leonhiem/codeswitch/README.md

# codeswitch
Codeswitch to open/close a relay
