leonhiem/codeswitch/pcb/pcb.pdf

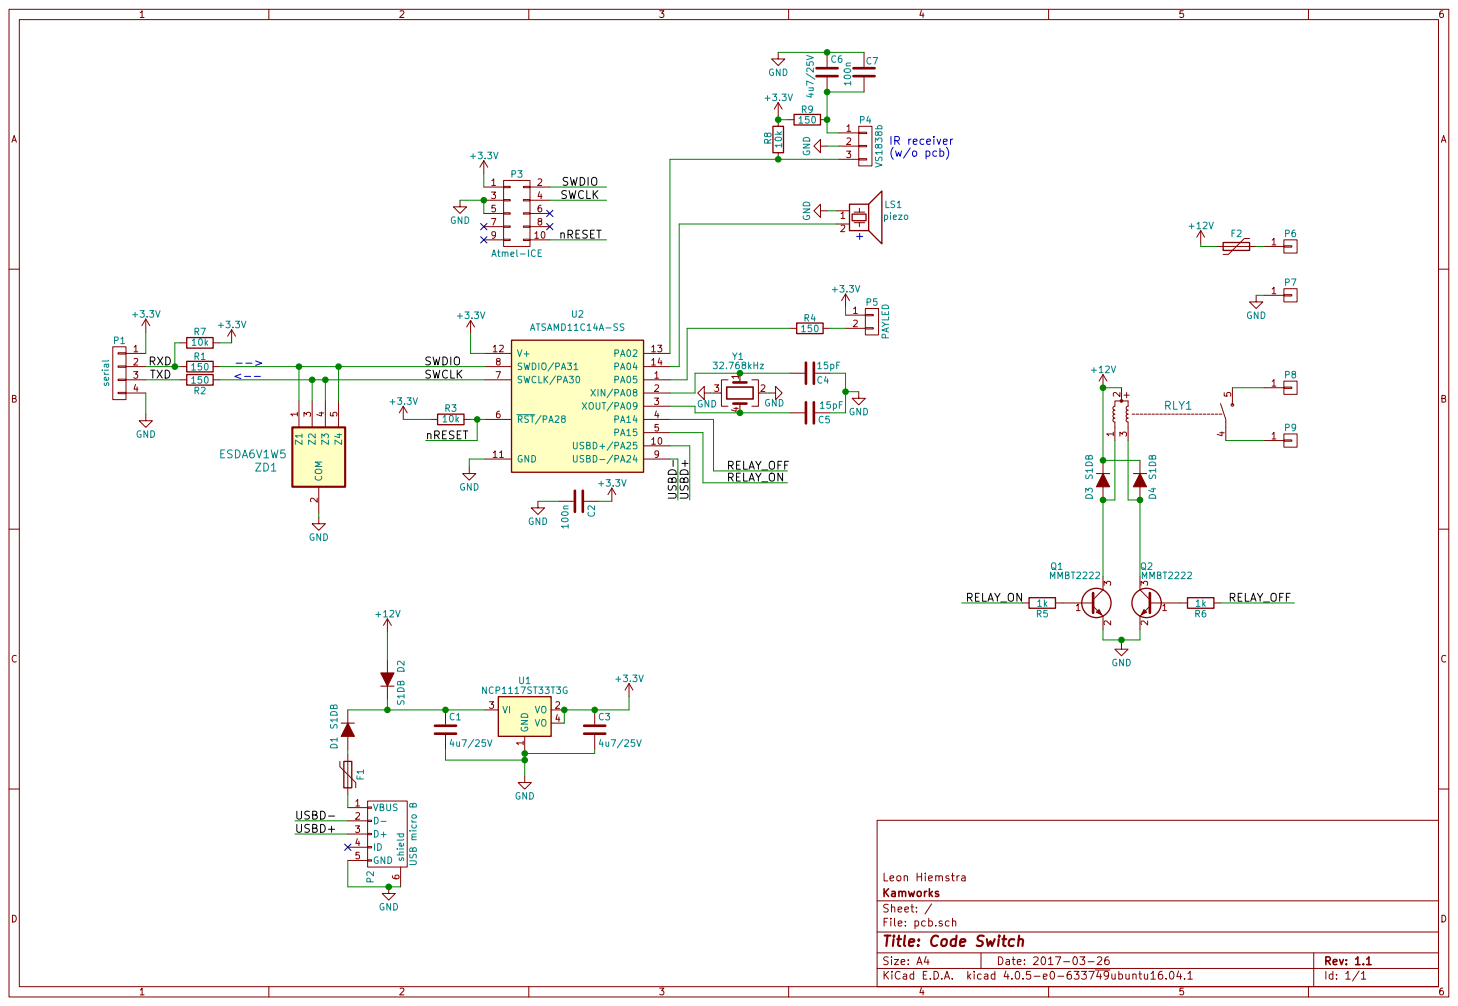
[picture p2: page 1]

Leon Hiemstra
File: pcb.sch Sheet: / Kamworks

Id: 1/1 Title: Code Switch
