leonhiem/codeswitch/pcb/pcb.kicad_pcb

## KiCad design pcb/pcb.kicad_pcb (2021-10-01)

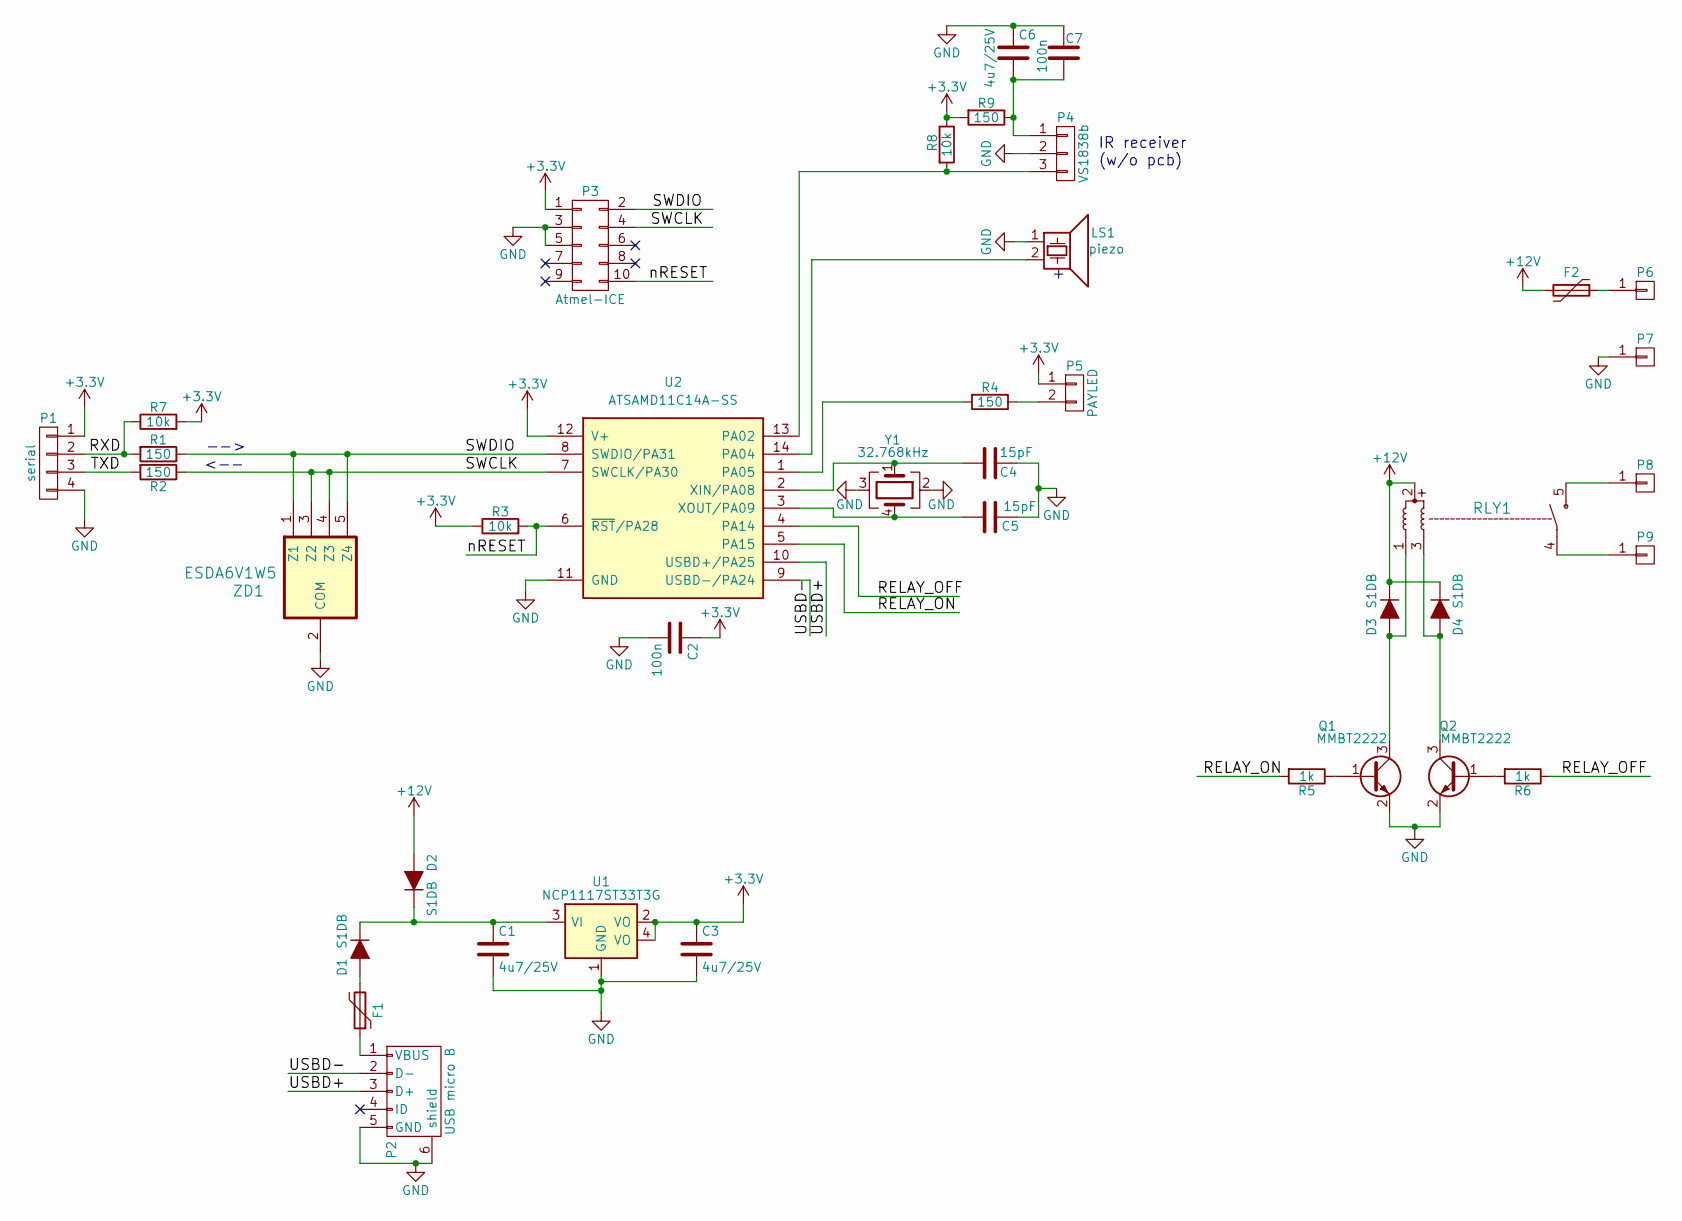
[picture p3: schematic pcb.sch, Code Switch]

Parts:
C1, C3, C6: 4u7/25V; C_0805_reflow
C2, C7: 100n; C_0805_reflow
C4, C5: 15pF; C_0805_reflow
D1, D2, D3, D4: S1DB; D_SMB_Handsoldering
F1: Polyfuse 250mA-hold 500mA-trip; Fuse_SMD1206_HandSoldering
F2: Polyfuse 1.1A-hold 2.2A-trip; R_1812
LS1: piezo; MagneticBuzzer_StarMicronics_HMB-06_HMB-12
P1: serial; Pin_Header_Straight_1x04_Pitch2.54mm
P2: USB micro B; USB_Micro-B_10103594-0001LF
P3: Atmel-ICE; Atmel_ICE
P4: VS1838b; Pin_Header_Straight_1x03_Pitch2.54mm
P5: PAYLED; Pin_Header_Straight_1x02_Pitch2.54mm
P6, P7, P8, P9: (faston male 6.35mm); faston_m_63
Q1, Q2: MMBT2222; SOT-23
R1, R2, R4, R9: 150; R_0805_reflow
R3, R7, R8: 10k; R_0805_reflow
R5, R6: 1k; R_0805_reflow
RLY1: RAMWAY_DS903C-90A_12V_D
U1: NCP1117ST33T3G; SOT-223
U2: ATSAMD11C14A-SS; SOIC-14_3.9x8.7mm_Pitch1.27mm
Y1: 32.768kHz; Crystal_SMD_Abracon_4pin_32768khz
ZD1: ESDA6V1W5; SOT-353_SC-70-5_Handsoldering

Connections:
+3V3: C2.1, C3.1, P1.1, P3.1, P5.1, R3.1, R7.2, R8.1, R9.2, U1.2 (VO), U1.4 (VO), U2.12 (V+)
+12V: D2.2 (A), D3.1 (K), D4.1 (K), F2.2, RLY1.2
/RELAY_OFF: R6.1, U2.4 (PA14)
/RELAY_ON: R5.2, U2.5 (PA15)
/RXD: P1.2, R1.2, R7.1
/SWCLK: P3.4, R2.1, U2.7 (SWCLK/PA30), ZD1.3 (Z2), ZD1.4 (Z3)
/SWDIO: P3.2, R1.1, U2.8 (SWDIO/PA31), ZD1.1 (Z1), ZD1.5 (Z4)
/TXD: P1.3, R2.2
/USBD+: P2.3 (D+), U2.10 (USBD+/PA25)
/USBD-: P2.2 (D-), U2.9 (USBD-/PA24)
/nRESET: P3.10, R3.2, U2.6 (~RST~/PA28)
GND: C1.2, C2.2, C3.2, C4.1, C5.1, C6.1, C7.2, LS1.1, P1.4, P2.5 (GND), P2.6 (shield), P3.3, P3.5, P4.2, P7.1, Q1.2 (E), Q2.2 (E), U1.1 (GND), U2.11 (GND), Y1.2, Y1.3, ZD1.2 (COM)
unnamed: C1.1, D1.1 (K), D2.1 (K), U1.3 (VI)
unnamed: C4.2, U2.2 (XIN/PA08), Y1.1
unnamed: C5.2, U2.3 (XOUT/PA09), Y1.4
unnamed: C6.2, C7.1, P4.1, R9.1
unnamed: D1.2 (A), F1.2
unnamed: D3.2 (A), Q1.3 (C), RLY1.1
unnamed: D4.2 (A), Q2.3 (C), RLY1.3
unnamed: F1.1, P2.1 (VBUS)
unnamed: F2.1, P6.1
unnamed: LS1.2, U2.14 (PA04)
unnamed: P4.3, R8.2, U2.13 (PA02)
unnamed: P5.2, R4.1
unnamed: P8.1, RLY1.5
unnamed: P9.1, RLY1.4
unnamed: Q1.1 (B), R5.1
unnamed: Q2.1 (B), R6.2
unnamed: R4.2, U2.1 (PA05)

Notes on the sheet:
IR receiver (w/o pcb)
-->
<--

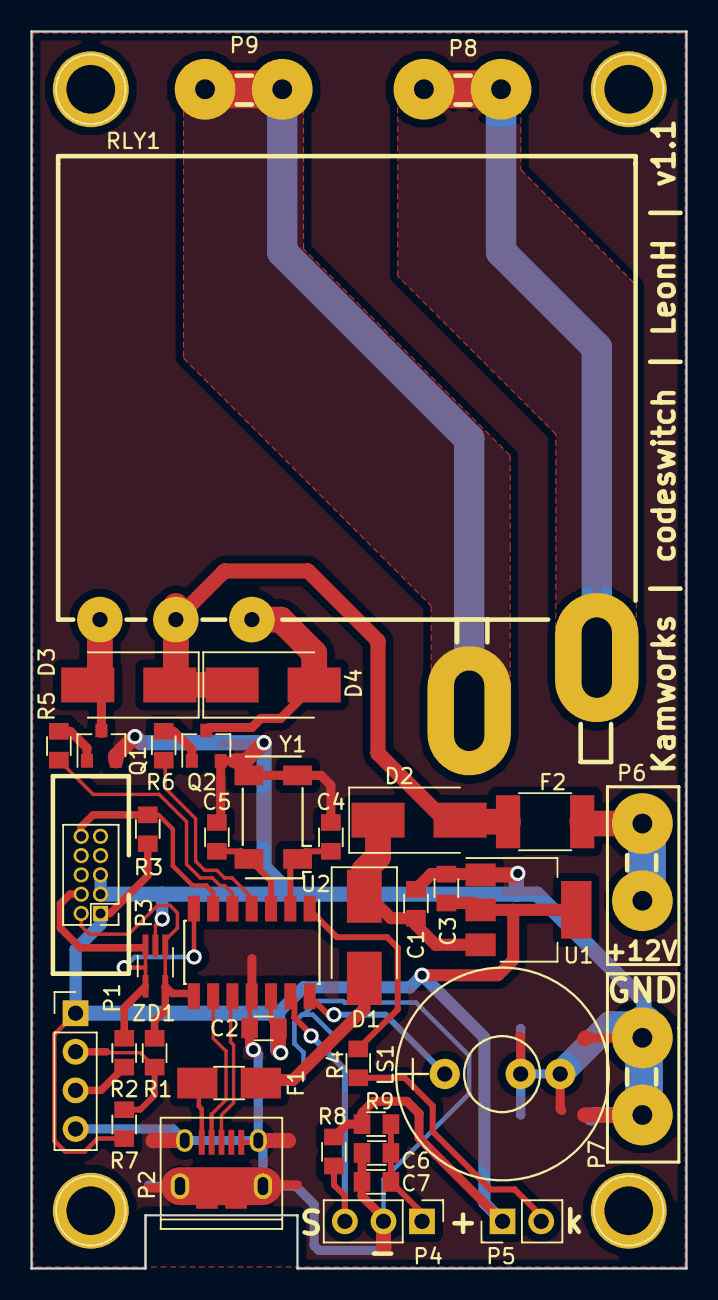
[picture p4: board pcb.kicad_pcb from above]

Board: 2 copper layers, 43.1 x 81.4 mm, 39 parts (0 on the bottom side), 29 nets.
